ClaudioBorges/MicroFEI-SmartCarBrazil2011/Hardware/PCB/TFC - car - BRD.pdf

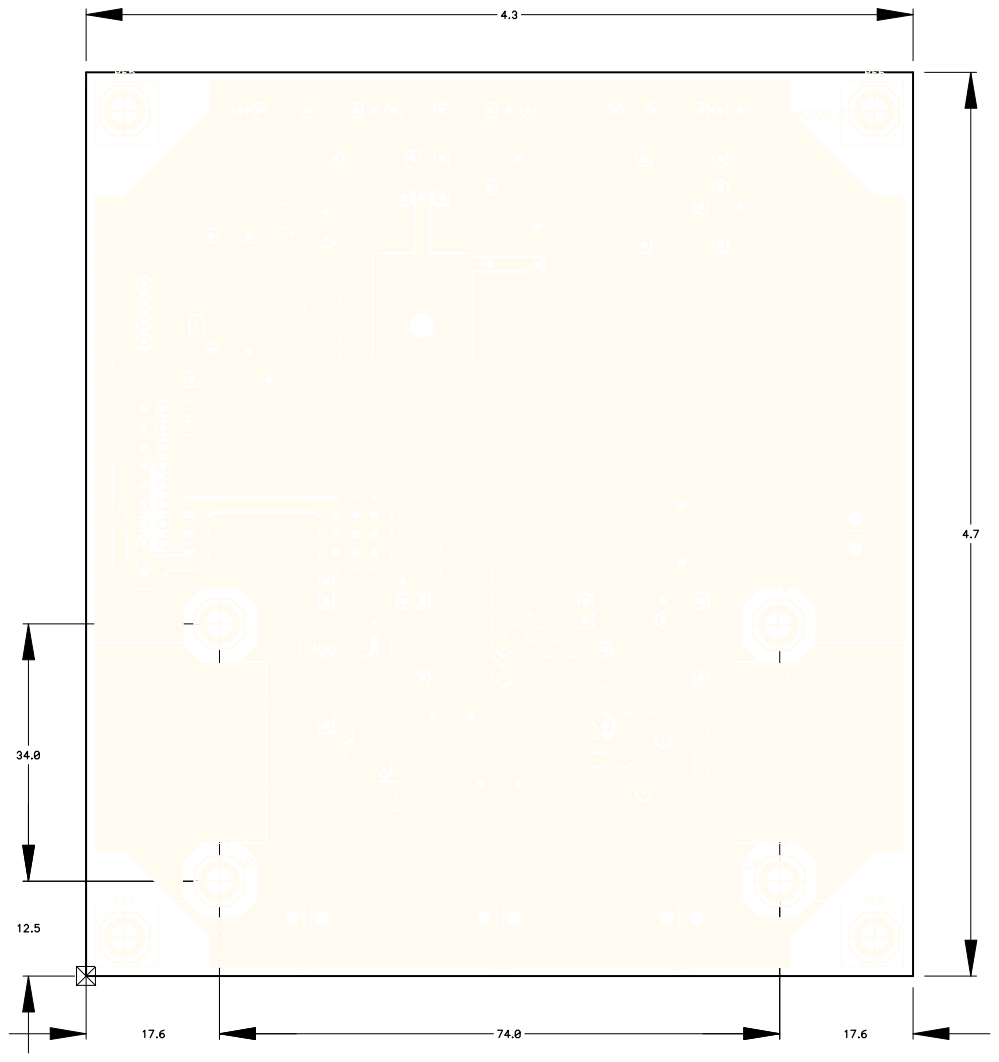
[picture p24: page 1]
