ClaudioBorges/MicroFEI-SmartCarBrazil2011/Hardware/PCB/TFC - car - SCH.pdf

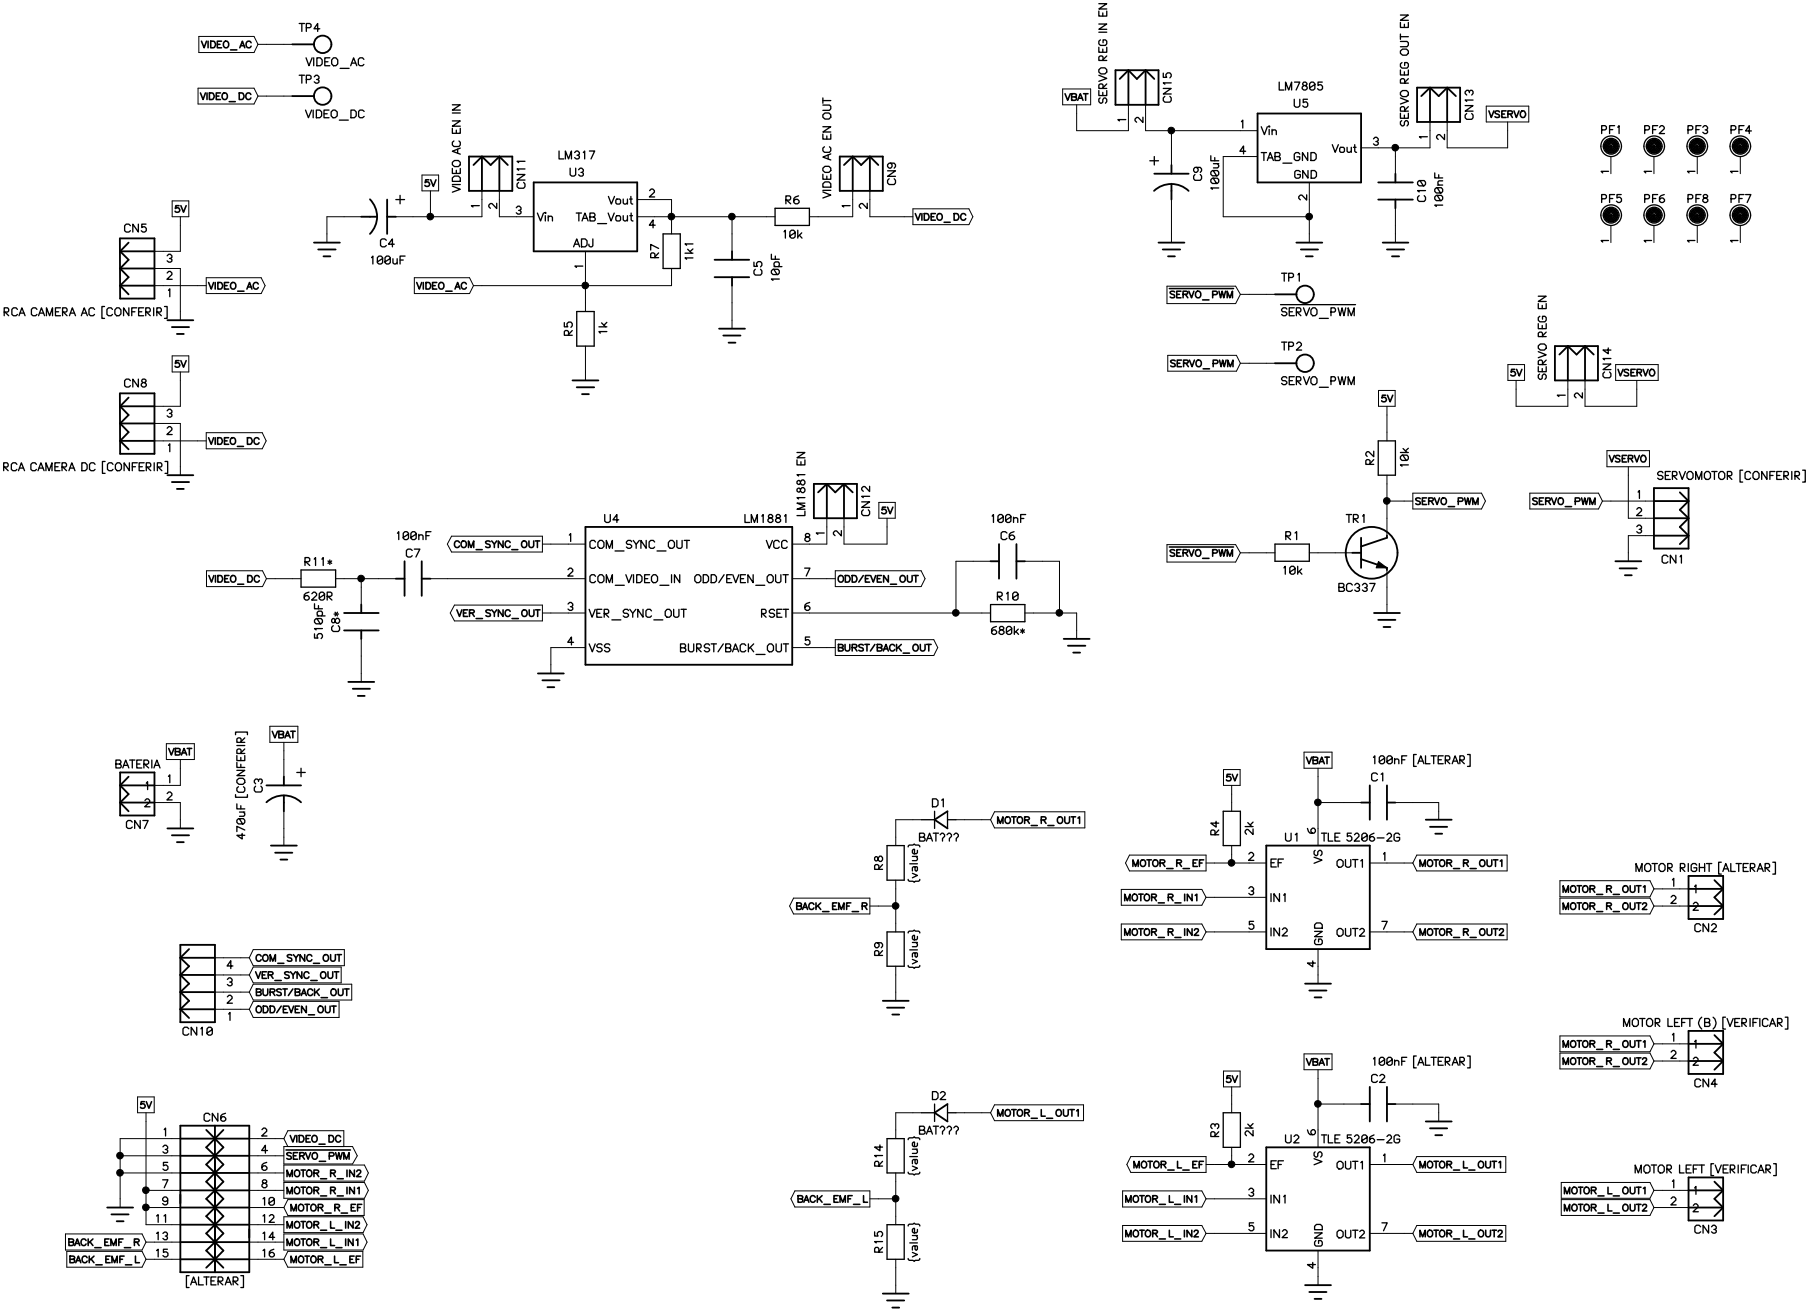
[picture p25: page 1]
