ClaudioBorges/MicroFEI-SmartCarBrazil2011/Hardware/PCB/TFC - car - SLK.pdf

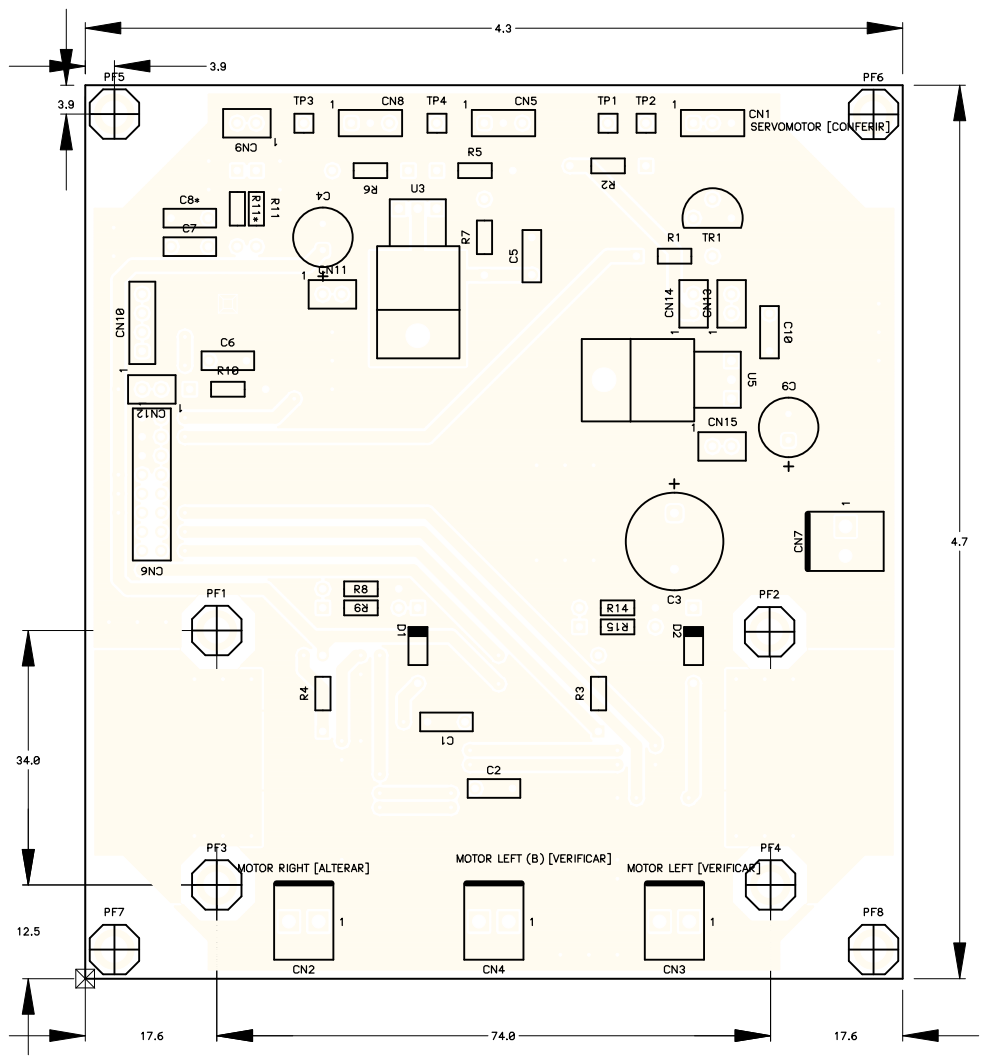
[picture p26: page 1]
