ClaudioBorges/MicroFEI-SmartCarBrazil2011/(list of files, drawings)

Other design files:
Hardware/PCB/TFC - car.pcb
