ClaudioBorges/MicroFEI-SmartCarBrazil2011/TFC - SmartCar/SIU/siu_init.c

/*
 *######################################################################
 *                                RAppIDJDP
 *           Rapid Application Initialization and Documentation Tool
 *                         Freescale Semiconductor Inc.
 *
 *######################################################################
 *
 * Project Name           : SAIC ADC
 *
 * Project File           : SAIC ADC.rsp
 *
 * Revision Number        : 1.0
 *
 * Tool Version           : 1.3.1.6
 *
 * file                   : siu_init.c
 *
 * Target Compiler        : Diab
 *
 * Target Part            : MPC5604B
 *
 * Part Errata Fixes      : none
 *
 * Project Last Save Date : 06-Aug-2011 14:36:06
 *
 * Created on Date        : 06-Aug-2011 14:36:10
 *
 * Brief Description      : This File Contains Pads, external Interrupts and
 *                          Wakeups configuration
 *
 ******************************************************************************** 
 *
 * Detail Description     : This File contains function for peripheral assignment
 *                         for each pads, External Interrupt configuration,
 *                         Wakeup configuration and Trigger configuration.
 *                         It also handles Port parallel masking.
 *
 ******************************************************************************** 
 *
 *######################################################################
*/

 
 
/********************  Dependent Include files here **********************/

#include "siu_init.h"
#include "MPC5604B_0M27V_0102.h" /* Use proper include file */

/* ----------------------------------------------------------- */
/*	                SIU Initialization                         */
/* ----------------------------------------------------------- */
void siu_init_fnc(void)
{
    siu_portA_init_fnc();
    siu_portB_init_fnc();
    siu_portC_init_fnc();
    siu_portD_init_fnc();
    siu_portE_init_fnc();
    siu_portF_init_fnc();
    siu_portG_init_fnc();
    siu_portH_init_fnc();
    siu_general_init_fnc();
    siu_parallel_port_init_fnc();
    siu_unused_pins_init_fnc();
    siu_psmi_init_fnc();
}


/* ----------------------------------------------------------- */
/*                 SIU PORT A PAD Configuration                 */
/* ----------------------------------------------------------- */
void siu_portA_init_fnc(void)
{
    /* ----------------------------------------------------------- */
    /*      Pad Configuration Register PCR[0]  eMIOS_0_0_CLKOUT_PA0 (16) */
    /* ----------------------------------------------------------- */
       SIU.PCR[0].R = 0x0501;
             /* User Assigned Signal Name : SAIC_CH0  */
             /*	Selected Function : eMIOS_0_0 I          */
             /*	Output Buffers : Disabled         */
             /*	Input Buffers : Enabled           */
             /*	Output Drain : Disabled           */
             /*	Slew Rate Control : Minimum       */
             /*	Weak Pull Up/Down : Disabled      */
             /*	Weak Pull Up/Down Select : Up     */
             /*	Safe Mode Control: Disabled       */

    /* ----------------------------------------------------------- */
    /*      Pad Configuration Register PCR[1]  eMIOS_0_1_NMI_PA1 (11) */
    /* ----------------------------------------------------------- */
       SIU.PCR[1].R = 0x0601;
             /*	Selected Function : eMIOS_0_1 O          */
             /*	Output Buffers : Enabled          */
             /*	Input Buffers : Disabled          */
             /*	Output Drain : Disabled           */
             /*	Slew Rate Control : Minimum       */
             /*	Weak Pull Up/Down : Disabled      */
             /*	Weak Pull Up/Down Select : Up     */
             /*	Safe Mode Control: Disabled       */

    /* ----------------------------------------------------------- */
    /*      Pad Configuration Register PCR[2]  eMIOS_0_2_PA2 (9) */
    /* ----------------------------------------------------------- */
       SIU.PCR[2].R = 0x0001;
             /*	Selected Function : PA2          */
             /*	Output Buffers : Disabled         */
             /*	Input Buffers : Disabled          */
             /*	Output Drain : Disabled           */
             /*	Slew Rate Control : Minimum       */
             /*	Weak Pull Up/Down : Disabled      */
             /*	Weak Pull Up/Down Select : Up     */
             /*	Safe Mode Control: Disabled       */

    /* ----------------------------------------------------------- */
    /*      Pad Configuration Register PCR[3]  eMIOS_0_3_PA3 (90) */
    /* ----------------------------------------------------------- */
       SIU.PCR[3].R = 0x0001;
             /*	Selected Function : PA3          */
             /*	Output Buffers : Disabled         */
             /*	Input Buffers : Disabled          */
             /*	Output Drain : Disabled           */
             /*	Slew Rate Control : Minimum       */
             /*	Weak Pull Up/Down : Disabled      */
             /*	Weak Pull Up/Down Select : Up     */
             /*	Safe Mode Control: Disabled       */

    /* ----------------------------------------------------------- */
    /*      Pad Configuration Register PCR[4]  eMIOS_0_4_PA4 (43) */
    /* ----------------------------------------------------------- */
       SIU.PCR[4].R = 0x0001;
             /*	Selected Function : PA4          */
             /*	Output Buffers : Disabled         */
             /*	Input Buffers : Disabled          */
             /*	Output Drain : Disabled           */
             /*	Slew Rate Control : Minimum       */
             /*	Weak Pull Up/Down : Disabled      */
             /*	Weak Pull Up/Down Select : Up     */
             /*	Safe Mode Control: Disabled       */

    /* ----------------------------------------------------------- */
    /*      Pad Configuration Register PCR[5]  eMIOS_0_5_PA5 (118) */
    /* ----------------------------------------------------------- */
       SIU.PCR[5].R = 0x0001;
             /*	Selected Function : PA5          */
             /*	Output Buffers : Disabled         */
             /*	Input Buffers : Disabled          */
             /*	Output Drain : Disabled           */
             /*	Slew Rate Control : Minimum       */
             /*	Weak Pull Up/Down : Disabled      */
             /*	Weak Pull Up/Down Select : Up     */
             /*	Safe Mode Control: Disabled       */

    /* ----------------------------------------------------------- */
    /*      Pad Configuration Register PCR[6]  eMIOS_0_6_PA6 (119) */
    /* ----------------------------------------------------------- */
       SIU.PCR[6].R = 0x0001;
             /*	Selected Function : PA6          */
             /*	Output Buffers : Disabled         */
             /*	Input Buffers : Disabled          */
             /*	Output Drain : Disabled           */
             /*	Slew Rate Control : Minimum       */
             /*	Weak Pull Up/Down : Disabled      */
             /*	Weak Pull Up/Down Select : Up     */
             /*	Safe Mode Control: Disabled       */

    /* ----------------------------------------------------------- */
    /*      Pad Configuration Register PCR[7]  eMIOS_0_7_TXD_3_PA7 (104) */
    /* ----------------------------------------------------------- */
       SIU.PCR[7].R = 0x0001;
             /*	Selected Function : PA7          */
             /*	Output Buffers : Disabled         */
             /*	Input Buffers : Disabled          */
             /*	Output Drain : Disabled           */
             /*	Slew Rate Control : Minimum       */
             /*	Weak Pull Up/Down : Disabled      */
             /*	Weak Pull Up/Down Select : Up     */
             /*	Safe Mode Control: Disabled       */

    /* ----------------------------------------------------------- */
    /*      Pad Configuration Register PCR[8]  eMIOS_0_8_RXD_3_PA8 (105) */
    /* ----------------------------------------------------------- */
       SIU.PCR[8].R = 0x0103;
             /*	Selected Function : PA8 I          */
             /*	Output Buffers : Disabled         */
             /*	Input Buffers : Enabled           */
             /*	Output Drain : Disabled           */
             /*	Slew Rate Control : Minimum       */
             /*	Weak Pull Up/Down : Enabled       */
             /*	Weak Pull Up/Down Select : Up     */
             /*	Safe Mode Control: Disabled       */

    /* ----------------------------------------------------------- */
    /*      Pad Configuration Register PCR[9]  eMIOS_0_9_PA9 (106) */
    /* ----------------------------------------------------------- */
       SIU.PCR[9].R = 0x0102;
             /*	Selected Function : PA9 I          */
             /*	Output Buffers : Disabled         */
             /*	Input Buffers : Enabled           */
             /*	Output Drain : Disabled           */
             /*	Slew Rate Control : Minimum       */
             /*	Weak Pull Up/Down : Enabled       */
             /*	Weak Pull Up/Down Select : Down   */
             /*	Safe Mode Control: Disabled       */

    /* ----------------------------------------------------------- */
    /*      Pad Configuration Register PCR[10]  eMIOS_0_10_SDA_0_PA10 (107) */
    /* ----------------------------------------------------------- */
       SIU.PCR[10].R = 0x0001;
             /*	Selected Function : PA10          */
             /*	Output Buffers : Disabled         */
             /*	Input Buffers : Disabled          */
             /*	Output Drain : Disabled           */
             /*	Slew Rate Control : Minimum       */
             /*	Weak Pull Up/Down : Disabled      */
             /*	Weak Pull Up/Down Select : Up     */
             /*	Safe Mode Control: Disabled       */

    /* ----------------------------------------------------------- */
    /*      Pad Configuration Register PCR[11]  eMIOS_0_11_SCL_0_PA11 (108) */
    /* ----------------------------------------------------------- */
       SIU.PCR[11].R = 0x0001;
             /*	Selected Function : PA11          */
             /*	Output Buffers : Disabled         */
             /*	Input Buffers : Disabled          */
             /*	Output Drain : Disabled           */
             /*	Slew Rate Control : Minimum       */
             /*	Weak Pull Up/Down : Disabled      */
             /*	Weak Pull Up/Down Select : Up     */
             /*	Safe Mode Control: Disabled       */

    /* ----------------------------------------------------------- */
    /*      Pad Configuration Register PCR[12]  SIN_0_PA12 (45) */
    /* ----------------------------------------------------------- */
       SIU.PCR[12].R = 0x0001;
             /*	Selected Function : PA12          */
             /*	Output Buffers : Disabled         */
             /*	Input Buffers : Disabled          */
             /*	Output Drain : Disabled           */
             /*	Slew Rate Control : Minimum       */
             /*	Weak Pull Up/Down : Disabled      */
             /*	Weak Pull Up/Down Select : Up     */
             /*	Safe Mode Control: Disabled       */

    /* ----------------------------------------------------------- */
    /*      Pad Configuration Register PCR[13]  SOUT_0_PA13 (44) */
    /* ----------------------------------------------------------- */
       SIU.PCR[13].R = 0x0001;
             /*	Selected Function : PA13          */
             /*	Output Buffers : Disabled         */
             /*	Input Buffers : Disabled          */
             /*	Output Drain : Disabled           */
             /*	Slew Rate Control : Minimum       */
             /*	Weak Pull Up/Down : Disabled      */
             /*	Weak Pull Up/Down Select : Up     */
             /*	Safe Mode Control: Disabled       */

    /* ----------------------------------------------------------- */
    /*      Pad Configuration Register PCR[14]  SCK_0_PCS_0.0_PA14 (42) */
    /* ----------------------------------------------------------- */
       SIU.PCR[14].R = 0x0001;
             /*	Selected Function : PA14          */
             /*	Output Buffers : Disabled         */
             /*	Input Buffers : Disabled          */
             /*	Output Drain : Disabled           */
             /*	Slew Rate Control : Minimum       */
             /*	Weak Pull Up/Down : Disabled      */
             /*	Weak Pull Up/Down Select : Up     */
             /*	Safe Mode Control: Disabled       */

    /* ----------------------------------------------------------- */
    /*      Pad Configuration Register PCR[15]  PCS_0.0_SCK_0_PA15 (40) */
    /* ----------------------------------------------------------- */
       SIU.PCR[15].R = 0x0001;
             /*	Selected Function : PA15          */
             /*	Output Buffers : Disabled         */
             /*	Input Buffers : Disabled          */
             /*	Output Drain : Disabled           */
             /*	Slew Rate Control : Minimum       */
             /*	Weak Pull Up/Down : Disabled      */
             /*	Weak Pull Up/Down Select : Up     */
             /*	Safe Mode Control: Disabled       */

}


/* ----------------------------------------------------------- */
/*                 SIU PORT B PAD Configuration                 */
/* ----------------------------------------------------------- */
void siu_portB_init_fnc(void)
{
    /* ----------------------------------------------------------- */
    /*      Pad Configuration Register PCR[16]  CNTX_0_PB0 (31) */
    /* ----------------------------------------------------------- */
       SIU.PCR[16].R = 0x0001;
             /*	Selected Function : PB0          */
             /*	Output Buffers : Disabled         */
             /*	Input Buffers : Disabled          */
             /*	Output Drain : Disabled           */
             /*	Slew Rate Control : Minimum       */
             /*	Weak Pull Up/Down : Disabled      */
             /*	Weak Pull Up/Down Select : Up     */
             /*	Safe Mode Control: Disabled       */

    /* ----------------------------------------------------------- */
    /*      Pad Configuration Register PCR[17]  CNRX_0_PB1 (32) */
    /* ----------------------------------------------------------- */
       SIU.PCR[17].R = 0x0001;
             /*	Selected Function : PB1          */
             /*	Output Buffers : Disabled         */
             /*	Input Buffers : Disabled          */
             /*	Output Drain : Disabled           */
             /*	Slew Rate Control : Minimum       */
             /*	Weak Pull Up/Down : Disabled      */
             /*	Weak Pull Up/Down Select : Up     */
             /*	Safe Mode Control: Disabled       */

    /* ----------------------------------------------------------- */
    /*      Pad Configuration Register PCR[18]  TXD_0_SDA_0_PB2 (144) */
    /* ----------------------------------------------------------- */
       SIU.PCR[18].R = 0x0001;
             /*	Selected Function : PB2          */
             /*	Output Buffers : Disabled         */
             /*	Input Buffers : Disabled          */
             /*	Output Drain : Disabled           */
             /*	Slew Rate Control : Minimum       */
             /*	Weak Pull Up/Down : Disabled      */
             /*	Weak Pull Up/Down Select : Up     */
             /*	Safe Mode Control: Disabled       */

    /* ----------------------------------------------------------- */
    /*      Pad Configuration Register PCR[19]  RXD_0_SCL_0_PB3 (1) */
    /* ----------------------------------------------------------- */
       SIU.PCR[19].R = 0x0001;
             /*	Selected Function : PB3          */
             /*	Output Buffers : Disabled         */
             /*	Input Buffers : Disabled          */
             /*	Output Drain : Disabled           */
             /*	Slew Rate Control : Minimum       */
             /*	Weak Pull Up/Down : Disabled      */
             /*	Weak Pull Up/Down Select : Up     */
             /*	Safe Mode Control: Disabled       */

    /* ----------------------------------------------------------- */
    /*      Pad Configuration Register PCR[20]  ADC0_ANP0_PB4 (72) */
    /* ----------------------------------------------------------- */
       SIU.PCR[20].R = 0x0000;
             /*	Selected Function : PB4          */
             /*	Output Buffers : Disabled         */
             /*	Input Buffers : Disabled          */
             /*	Output Drain : Disabled           */
             /*	Slew Rate Control : Minimum       */
             /*	Weak Pull Up/Down : Disabled      */
             /*	Weak Pull Up/Down Select : Down   */
             /*	Safe Mode Control: Disabled       */

    /* ----------------------------------------------------------- */
    /*      Pad Configuration Register PCR[21]  ADC0_ANP1_PB5 (75) */
    /* ----------------------------------------------------------- */
       SIU.PCR[21].R = 0x0000;
             /*	Selected Function : PB5          */
             /*	Output Buffers : Disabled         */
             /*	Input Buffers : Disabled          */
             /*	Output Drain : Disabled           */
             /*	Slew Rate Control : Minimum       */
             /*	Weak Pull Up/Down : Disabled      */
             /*	Weak Pull Up/Down Select : Down   */
             /*	Safe Mode Control: Disabled       */

    /* ----------------------------------------------------------- */
    /*      Pad Configuration Register PCR[22]  ADC0_ANP2_PB6 (76) */
    /* ----------------------------------------------------------- */
       SIU.PCR[22].R = 0x0000;
             /*	Selected Function : PB6          */
             /*	Output Buffers : Disabled         */
             /*	Input Buffers : Disabled          */
             /*	Output Drain : Disabled           */
             /*	Slew Rate Control : Minimum       */
             /*	Weak Pull Up/Down : Disabled      */
             /*	Weak Pull Up/Down Select : Down   */
             /*	Safe Mode Control: Disabled       */

    /* ----------------------------------------------------------- */
    /*      Pad Configuration Register PCR[23]  ADC0_ANP3_PB7 (77) */
    /* ----------------------------------------------------------- */
       SIU.PCR[23].R = 0x0000;
             /*	Selected Function : PB7          */
             /*	Output Buffers : Disabled         */
             /*	Input Buffers : Disabled          */
             /*	Output Drain : Disabled           */
             /*	Slew Rate Control : Minimum       */
             /*	Weak Pull Up/Down : Disabled      */
             /*	Weak Pull Up/Down Select : Down   */
             /*	Safe Mode Control: Disabled       */

    /* ----------------------------------------------------------- */
    /*      Pad Configuration Register PCR[24]  XTAL32_ADC0_ANS0_PB8 (53) */
    /* ----------------------------------------------------------- */
       SIU.PCR[24].R = 0x2000;
             /* User Assigned Signal Name : ADC_ANS_0  */
             /*	Selected Function : ADC0_ANS0          */
             /*	Output Buffers : Disabled         */
             /*	Input Buffers : Disabled          */
             /*	Output Drain : Disabled           */
             /*	Slew Rate Control : Minimum       */
             /*	Weak Pull Up/Down : Disabled      */
             /*	Weak Pull Up/Down Select : Down   */
             /*	Safe Mode Control: Disabled       */

    /* ----------------------------------------------------------- */
    /*      Pad Configuration Register PCR[25]  EXTAL32_ADC0_ANS1_PB9 (52) */
    /* ----------------------------------------------------------- */
       SIU.PCR[25].R = 0x0000;
             /*	Selected Function : PB9          */
             /*	Output Buffers : Disabled         */
             /*	Input Buffers : Disabled          */
             /*	Output Drain : Disabled           */
             /*	Slew Rate Control : Minimum       */
             /*	Weak Pull Up/Down : Disabled      */
             /*	Weak Pull Up/Down Select : Down   */
             /*	Safe Mode Control: Disabled       */

    /* ----------------------------------------------------------- */
    /*      Pad Configuration Register PCR[26]  ADC0_ANS2_PB10 (54) */
    /* ----------------------------------------------------------- */
       SIU.PCR[26].R = 0x0001;
             /*	Selected Function : PB10          */
             /*	Output Buffers : Disabled         */
             /*	Input Buffers : Disabled          */
             /*	Output Drain : Disabled           */
             /*	Slew Rate Control : Minimum       */
             /*	Weak Pull Up/Down : Disabled      */
             /*	Weak Pull Up/Down Select : Up     */
             /*	Safe Mode Control: Disabled       */

    /* ----------------------------------------------------------- */
    /*      Pad Configuration Register PCR[27]  eMIOS_0_3_PCS_0.0_ADC0_ANS3_PB11 (81) */
    /* ----------------------------------------------------------- */
       SIU.PCR[27].R = 0x0001;
             /*	Selected Function : PB11          */
             /*	Output Buffers : Disabled         */
             /*	Input Buffers : Disabled          */
             /*	Output Drain : Disabled           */
             /*	Slew Rate Control : Minimum       */
             /*	Weak Pull Up/Down : Disabled      */
             /*	Weak Pull Up/Down Select : Up     */
             /*	Safe Mode Control: Disabled       */

    /* ----------------------------------------------------------- */
    /*      Pad Configuration Register PCR[28]  eMIOS_0_4_PCS_0.1_ADC0_ANX0_PB12 (83) */
    /* ----------------------------------------------------------- */
       SIU.PCR[28].R = 0x0001;
             /*	Selected Function : PB12          */
             /*	Output Buffers : Disabled         */
             /*	Input Buffers : Disabled          */
             /*	Output Drain : Disabled           */
             /*	Slew Rate Control : Minimum       */
             /*	Weak Pull Up/Down : Disabled      */
             /*	Weak Pull Up/Down Select : Up     */
             /*	Safe Mode Control: Disabled       */

    /* ----------------------------------------------------------- */
    /*      Pad Configuration Register PCR[29]  eMIOS_0_5_PCS_0.2_ADC0_ANX1_PB13 (85) */
    /* ----------------------------------------------------------- */
       SIU.PCR[29].R = 0x0001;
             /*	Selected Function : PB13          */
             /*	Output Buffers : Disabled         */
             /*	Input Buffers : Disabled          */
             /*	Output Drain : Disabled           */
             /*	Slew Rate Control : Minimum       */
             /*	Weak Pull Up/Down : Disabled      */
             /*	Weak Pull Up/Down Select : Up     */
             /*	Safe Mode Control: Disabled       */

    /* ----------------------------------------------------------- */
    /*      Pad Configuration Register PCR[30]  eMIOS_0_6_PCS_0.3_ADC0_ANX2_PB14 (87) */
    /* ----------------------------------------------------------- */
       SIU.PCR[30].R = 0x0001;
             /*	Selected Function : PB14          */
             /*	Output Buffers : Disabled         */
             /*	Input Buffers : Disabled          */
             /*	Output Drain : Disabled           */
             /*	Slew Rate Control : Minimum       */
             /*	Weak Pull Up/Down : Disabled      */
             /*	Weak Pull Up/Down Select : Up     */
             /*	Safe Mode Control: Disabled       */

    /* ----------------------------------------------------------- */
    /*      Pad Configuration Register PCR[31]  eMIOS_0_7_PCS_0.4_ADC0_ANX3_PB15 (89) */
    /* ----------------------------------------------------------- */
       SIU.PCR[31].R = 0x0001;
             /*	Selected Function : PB15          */
             /*	Output Buffers : Disabled         */
             /*	Input Buffers : Disabled          */
             /*	Output Drain : Disabled           */
             /*	Slew Rate Control : Minimum       */
             /*	Weak Pull Up/Down : Disabled      */
             /*	Weak Pull Up/Down Select : Up     */
             /*	Safe Mode Control: Disabled       */

}


/* ----------------------------------------------------------- */
/*                 SIU PORT C PAD Configuration                 */
/* ----------------------------------------------------------- */
void siu_portC_init_fnc(void)
{
    /* ----------------------------------------------------------- */
    /*      Pad Configuration Register PCR[32]  TDI_PC0 (126) */
    /* ----------------------------------------------------------- */
       SIU.PCR[32].R = 0x4903;
             /*	Selected Function : TDI          */
             /*	Output Buffers : Disabled         */
             /*	Input Buffers : Enabled           */
             /*	Output Drain : Disabled           */
             /*	Slew Rate Control : Minimum       */
             /*	Weak Pull Up/Down : Enabled       */
             /*	Weak Pull Up/Down Select : Up     */
             /*	Safe Mode Control: Enabled       */

    /* ----------------------------------------------------------- */
    /*      Pad Configuration Register PCR[33]  TDO_PC1 (121) */
    /* ----------------------------------------------------------- */
       SIU.PCR[33].R = 0x4A01;
             /*	Selected Function : TDO          */
             /*	Output Buffers : Enabled          */
             /*	Input Buffers : Disabled          */
             /*	Output Drain : Disabled           */
             /*	Slew Rate Control : Minimum       */
             /*	Weak Pull Up/Down : Disabled      */
             /*	Weak Pull Up/Down Select : Up     */
             /*	Safe Mode Control: Enabled       */

    /* ----------------------------------------------------------- */
    /*      Pad Configuration Register PCR[34]  SCK_1_PC2 (117) */
    /* ----------------------------------------------------------- */
       SIU.PCR[34].R = 0x0001;
             /*	Selected Function : PC2          */
             /*	Output Buffers : Disabled         */
             /*	Input Buffers : Disabled          */
             /*	Output Drain : Disabled           */
             /*	Slew Rate Control : Minimum       */
             /*	Weak Pull Up/Down : Disabled      */
             /*	Weak Pull Up/Down Select : Up     */
             /*	Safe Mode Control: Disabled       */

    /* ----------------------------------------------------------- */
    /*      Pad Configuration Register PCR[35]  PCS_1.0_ADC_MA0_CNRX_1_PC3 (116) */
    /* ----------------------------------------------------------- */
       SIU.PCR[35].R = 0x0001;
             /*	Selected Function : PC3          */
             /*	Output Buffers : Disabled         */
             /*	Input Buffers : Disabled          */
             /*	Output Drain : Disabled           */
             /*	Slew Rate Control : Minimum       */
             /*	Weak Pull Up/Down : Disabled      */
             /*	Weak Pull Up/Down Select : Up     */
             /*	Safe Mode Control: Disabled       */

    /* ----------------------------------------------------------- */
    /*      Pad Configuration Register PCR[36]  SIN_1_PC4 (131) */
    /* ----------------------------------------------------------- */
       SIU.PCR[36].R = 0x0001;
             /*	Selected Function : PC4          */
             /*	Output Buffers : Disabled         */
             /*	Input Buffers : Disabled          */
             /*	Output Drain : Disabled           */
             /*	Slew Rate Control : Minimum       */
             /*	Weak Pull Up/Down : Disabled      */
             /*	Weak Pull Up/Down Select : Up     */
             /*	Safe Mode Control: Disabled       */

    /* ----------------------------------------------------------- */
    /*      Pad Configuration Register PCR[37]  SOUT_1_PC5 (130) */
    /* ----------------------------------------------------------- */
       SIU.PCR[37].R = 0x0001;
             /*	Selected Function : PC5          */
             /*	Output Buffers : Disabled         */
             /*	Input Buffers : Disabled          */
             /*	Output Drain : Disabled           */
             /*	Slew Rate Control : Minimum       */
             /*	Weak Pull Up/Down : Disabled      */
             /*	Weak Pull Up/Down Select : Up     */
             /*	Safe Mode Control: Disabled       */

    /* ----------------------------------------------------------- */
    /*      Pad Configuration Register PCR[38]  TXD_1_PC6 (36) */
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
             /*	Output Drain : Disabled           */
             /*	Slew Rate Control : Minimum       */
             /*	Weak Pull Up/Down : Disabled      */
             /*	Weak Pull Up/Down Select : Up     */
             /*	Safe Mode Control: Disabled       */

    /* ----------------------------------------------------------- */
    /*      Pad Configuration Register PCR[44]  eMIOS_0_12_SIN_2_PC12 (141) */
    /* ----------------------------------------------------------- */
       SIU.PCR[44].R = 0x0001;
             /*	Selected Function : PC12          */
             /*	Output Buffers : Disabled         */
             /*	Input Buffers : Disabled          */
             /*	Output Drain : Disabled           */
             /*	Slew Rate Control : Minimum       */
             /*	Weak Pull Up/Down : Disabled      */
             /*	Weak Pull Up/Down Select : Up     */
             /*	Safe Mode Control: Disabled       */

    /* ----------------------------------------------------------- */
    /*      Pad Configuration Register PCR[45]  eMIOS_0_13_SOUT_2_PC13 (142) */
    /* ----------------------------------------------------------- */
       SIU.PCR[45].R = 0x0001;
             /*	Selected Function : PC13          */
             /*	Output Buffers : Disabled         */
             /*	Input Buffers : Disabled          */
             /*	Output Drain : Disabled           */
             /*	Slew Rate Control : Minimum       */
             /*	Weak Pull Up/Down : Disabled      */
             /*	Weak Pull Up/Down Select : Up     */
             /*	Safe Mode Control: Disabled       */

    /* ----------------------------------------------------------- */
    /*      Pad Configuration Register PCR[46]  eMIOS_0_14_SCK_2_PC14 (3) */
    /* ----------------------------------------------------------- */
       SIU.PCR[46].R = 0x0001;
             /*	Selected Function : PC14          */
             /*	Output Buffers : Disabled         */
             /*	Input Buffers : Disabled          */
             /*	Output Drain : Disabled           */
             /*	Slew Rate Control : Minimum       */
             /*	Weak Pull Up/Down : Disabled      */
             /*	Weak Pull Up/Down Select : Up     */
             /*	Safe Mode Control: Disabled       */

    /* ----------------------------------------------------------- */
    /*      Pad Configuration Register PCR[47]  eMIOS_0_15_PCS_2.0_PC15 (4) */
    /* ----------------------------------------------------------- */
       SIU.PCR[47].R = 0x0001;
             /*	Selected Function : PC15          */
             /*	Output Buffers : Disabled         */
             /*	Input Buffers : Disabled          */
             /*	Output Drain : Disabled           */
             /*	Slew Rate Control : Minimum       */
             /*	Weak Pull Up/Down : Disabled      */
             /*	Weak Pull Up/Down Select : Up     */
             /*	Safe Mode Control: Disabled       */

}


/* ----------------------------------------------------------- */
/*                 SIU PORT D PAD Configuration                 */
/* ----------------------------------------------------------- */
void siu_portD_init_fnc(void)
{
    /* ----------------------------------------------------------- */
    /*      Pad Configuration Register PCR[48]  ADC0_ANP4_PD0 (63) */
    /* ----------------------------------------------------------- */
       SIU.PCR[48].R = 0x0000;
             /*	Selected Function : PD0          */
             /*	Output Buffers : Disabled         */
             /*	Input Buffers : Disabled          */
             /*	Output Drain : Disabled           */
             /*	Slew Rate Control : Minimum       */
             /*	Weak Pull Up/Down : Disabled      */
             /*	Weak Pull Up/Down Select : Down   */
             /*	Safe Mode Control: Disabled       */

    /* ----------------------------------------------------------- */
    /*      Pad Configuration Register PCR[49]  ADC0_ANP5_PD1 (64) */
    /* ----------------------------------------------------------- */
       SIU.PCR[49].R = 0x0000;
             /*	Selected Function : PD1          */
             /*	Output Buffers : Disabled         */
             /*	Input Buffers : Disabled          */
             /*	Output Drain : Disabled           */
             /*	Slew Rate Control : Minimum       */
             /*	Weak Pull Up/Down : Disabled      */
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
             /*	Output Drain : Disabled           */
             /*	Slew Rate Control : Minimum       */
             /*	Weak Pull Up/Down : Disabled      */
             /*	Weak Pull Up/Down Select : Up     */
             /*	Safe Mode Control: Disabled       */

}


/* ----------------------------------------------------------- */
/*                 SIU PORT E PAD Configuration                 */
/* ----------------------------------------------------------- */
void siu_portE_init_fnc(void)
{
    /* ----------------------------------------------------------- */
    /*      Pad Configuration Register PCR[64]  eMIOS_0_16_PE0 (10) */
    /* ----------------------------------------------------------- */
       SIU.PCR[64].R = 0x0001;
             /*	Selected Function : PE0          */
             /*	Output Buffers : Disabled         */
             /*	Input Buffers : Disabled          */
             /*	Output Drain : Disabled           */
             /*	Slew Rate Control : Minimum       */
             /*	Weak Pull Up/Down : Disabled      */
             /*	Weak Pull Up/Down Select : Up     */
             /*	Safe Mode Control: Disabled       */

    /* ----------------------------------------------------------- */
    /*      Pad Configuration Register PCR[65]  eMIOS_0_17_PE1 (12) */
    /* ----------------------------------------------------------- */
       SIU.PCR[65].R = 0x0001;
             /*	Selected Function : PE1          */
             /*	Output Buffers : Disabled         */
             /*	Input Buffers : Disabled          */
             /*	Output Drain : Disabled           */
             /*	Slew Rate Control : Minimum       */
             /*	Weak Pull Up/Down : Disabled      */
             /*	Weak Pull Up/Down Select : Up     */
             /*	Safe Mode Control: Disabled       */

    /* ----------------------------------------------------------- */
    /*      Pad Configuration Register PCR[66]  eMIOS_0_18_SIN_1_PE2 (128) */
    /* ----------------------------------------------------------- */
       SIU.PCR[66].R = 0x0001;
             /*	Selected Function : PE2          */
             /*	Output Buffers : Disabled         */
             /*	Input Buffers : Disabled          */
             /*	Output Drain : Disabled           */
             /*	Slew Rate Control : Minimum       */
             /*	Weak Pull Up/Down : Disabled      */
             /*	Weak Pull Up/Down Select : Up     */
             /*	Safe Mode Control: Disabled       */

    /* ----------------------------------------------------------- */
    /*      Pad Configuration Register PCR[67]  eMIOS_0_19_SOUT_1_PE3 (129) */
    /* ----------------------------------------------------------- */
       SIU.PCR[67].R = 0x0001;
             /*	Selected Function : PE3          */
             /*	Output Buffers : Disabled         */
             /*	Input Buffers : Disabled          */
             /*	Output Drain : Disabled           */
             /*	Slew Rate Control : Minimum       */
             /*	Weak Pull Up/Down : Disabled      */
             /*	Weak Pull Up/Down Select : Up     */
             /*	Safe Mode Control: Disabled       */

    /* ----------------------------------------------------------- */
    /*      Pad Configuration Register PCR[68]  eMIOS_0_20_SCK_1_PE4 (132) */
    /* ----------------------------------------------------------- */
       SIU.PCR[68].R = 0x0001;
             /*	Selected Function : PE4          */
             /*	Output Buffers : Disabled         */
             /*	Input Buffers : Disabled          */
             /*	Output Drain : Disabled           */
             /*	Slew Rate Control : Minimum       */
             /*	Weak Pull Up/Down : Disabled      */
             /*	Weak Pull Up/Down Select : Up     */
             /*	Safe Mode Control: Disabled       */

    /* ----------------------------------------------------------- */
    /*      Pad Configuration Register PCR[69]  eMIOS_0_21_PCS_1.0_ADC_MA2_PE5 (133) */
    /* ----------------------------------------------------------- */
       SIU.PCR[69].R = 0x0001;
             /*	Selected Function : PE5          */
             /*	Output Buffers : Disabled         */
             /*	Input Buffers : Disabled          */
             /*	Output Drain : Disabled           */
             /*	Slew Rate Control : Minimum       */
             /*	Weak Pull Up/Down : Disabled      */
             /*	Weak Pull Up/Down Select : Up     */
             /*	Safe Mode Control: Disabled       */

    /* ----------------------------------------------------------- */
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
             /*	Output Drain : Disabled           */
             /*	Slew Rate Control : Minimum       */
             /*	Weak Pull Up/Down : Disabled      */
             /*	Weak Pull Up/Down Select : Up     */
             /*	Safe Mode Control: Disabled       */

    /* ----------------------------------------------------------- */
    /*      Pad Configuration Register PCR[76]  SIN_2_eMIOS_1_19_PE12 (109) */
    /* ----------------------------------------------------------- */
       SIU.PCR[76].R = 0x0001;
             /*	Selected Function : PE12          */
             /*	Output Buffers : Disabled         */
             /*	Input Buffers : Disabled          */
             /*	Output Drain : Disabled           */
             /*	Slew Rate Control : Minimum       */
             /*	Weak Pull Up/Down : Disabled      */
             /*	Weak Pull Up/Down Select : Up     */
             /*	Safe Mode Control: Disabled       */

    /* ----------------------------------------------------------- */
    /*      Pad Configuration Register PCR[77]  SOUT_2_eMIOS_1_20_PE13 (103) */
    /* ----------------------------------------------------------- */
       SIU.PCR[77].R = 0x0001;
             /*	Selected Function : PE13          */
             /*	Output Buffers : Disabled         */
             /*	Input Buffers : Disabled          */
             /*	Output Drain : Disabled           */
             /*	Slew Rate Control : Minimum       */
             /*	Weak Pull Up/Down : Disabled      */
             /*	Weak Pull Up/Down Select : Up     */
             /*	Safe Mode Control: Disabled       */

    /* ----------------------------------------------------------- */
    /*      Pad Configuration Register PCR[78]  SCK_2_eMIOS_1_21_PE14 (112) */
    /* ----------------------------------------------------------- */
       SIU.PCR[78].R = 0x0001;
             /*	Selected Function : PE14          */
             /*	Output Buffers : Disabled         */
             /*	Input Buffers : Disabled          */
             /*	Output Drain : Disabled           */
             /*	Slew Rate Control : Minimum       */
             /*	Weak Pull Up/Down : Disabled      */
             /*	Weak Pull Up/Down Select : Up     */
             /*	Safe Mode Control: Disabled       */

    /* ----------------------------------------------------------- */
    /*      Pad Configuration Register PCR[79]  PCS_2.0_eMIOS_1_22_PE15 (113) */
    /* ----------------------------------------------------------- */
       SIU.PCR[79].R = 0x0001;
             /*	Selected Function : PE15          */
             /*	Output Buffers : Disabled         */
             /*	Input Buffers : Disabled          */
             /*	Output Drain : Disabled           */
             /*	Slew Rate Control : Minimum       */
             /*	Weak Pull Up/Down : Disabled      */
             /*	Weak Pull Up/Down Select : Up     */
             /*	Safe Mode Control: Disabled       */

}


/* ----------------------------------------------------------- */
/*                 SIU PORT F PAD Configuration                 */
/* ----------------------------------------------------------- */
void siu_portF_init_fnc(void)
{
    /* ----------------------------------------------------------- */
    /*      Pad Configuration Register PCR[80]  eMIOS_0_10_PCS_1.3_ADC0_ANS8_PF0 (55) */
    /* ----------------------------------------------------------- */
       SIU.PCR[80].R = 0x0001;
             /*	Selected Function : PF0          */
             /*	Output Buffers : Disabled         */
             /*	Input Buffers : Disabled          */
             /*	Output Drain : Disabled           */
             /*	Slew Rate Control : Minimum       */
             /*	Weak Pull Up/Down : Disabled      */
             /*	Weak Pull Up/Down Select : Up     */
             /*	Safe Mode Control: Disabled       */

    /* ----------------------------------------------------------- */
    /*      Pad Configuration Register PCR[81]  eMIOS_0_11_PCS_1.4_ADC0_ANS9_PF1 (56) */
    /* ----------------------------------------------------------- */
       SIU.PCR[81].R = 0x0001;
             /*	Selected Function : PF1          */
             /*	Output Buffers : Disabled         */
             /*	Input Buffers : Disabled          */
             /*	Output Drain : Disabled           */
             /*	Slew Rate Control : Minimum       */
             /*	Weak Pull Up/Down : Disabled      */
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
             /*	Output Drain : Disabled           */
             /*	Slew Rate Control : Minimum       */
             /*	Weak Pull Up/Down : Disabled      */
             /*	Weak Pull Up/Down Select : Up     */
             /*	Safe Mode Control: Disabled       */

}


/* ----------------------------------------------------------- */
/*                 SIU PORT H PAD Configuration                 */
/* ----------------------------------------------------------- */
void siu_portH_init_fnc(void)
{
    /* ----------------------------------------------------------- */
    /*      Pad Configuration Register PCR[112]  eMIOS_1_2_SIN_1_PH0 (93) */
    /* ----------------------------------------------------------- */
       SIU.PCR[112].R = 0x0001;
             /*	Selected Function : PH0          */
             /*	Output Buffers : Disabled         */
             /*	Input Buffers : Disabled          */
             /*	Output Drain : Disabled           */
             /*	Slew Rate Control : Minimum       */
             /*	Weak Pull Up/Down : Disabled      */
             /*	Weak Pull Up/Down Select : Up     */
             /*	Safe Mode Control: Disabled       */

    /* ----------------------------------------------------------- */
    /*      Pad Configuration Register PCR[113]  eMIOS_1_3_SOUT_1_PH1 (94) */
    /* ----------------------------------------------------------- */
       SIU.PCR[113].R = 0x0001;
             /*	Selected Function : PH1          */
             /*	Output Buffers : Disabled         */
             /*	Input Buffers : Disabled          */
             /*	Output Drain : Disabled           */
             /*	Slew Rate Control : Minimum       */
             /*	Weak Pull Up/Down : Disabled      */
             /*	Weak Pull Up/Down Select : Up     */
             /*	Safe Mode Control: Disabled       */

    /* ----------------------------------------------------------- */
    /*      Pad Configuration Register PCR[114]  eMIOS_1_4_SCK_1_PH2 (95) */
    /* ----------------------------------------------------------- */
       SIU.PCR[114].R = 0x0001;
             /*	Selected Function : PH2          */
             /*	Output Buffers : Disabled         */
             /*	Input Buffers : Disabled          */
             /*	Output Drain : Disabled           */
             /*	Slew Rate Control : Minimum       */
             /*	Weak Pull Up/Down : Disabled      */
             /*	Weak Pull Up/Down Select : Up     */
             /*	Safe Mode Control: Disabled       */

    /* ----------------------------------------------------------- */
    /*      Pad Configuration Register PCR[115]  eMIOS_1_5_PCS_1.0_PH3 (96) */
    /* ----------------------------------------------------------- */
       SIU.PCR[115].R = 0x0001;
             /*	Selected Function : PH3          */
             /*	Output Buffers : Disabled         */
             /*	Input Buffers : Disabled          */
             /*	Output Drain : Disabled           */
             /*	Slew Rate Control : Minimum       */
             /*	Weak Pull Up/Down : Disabled      */
             /*	Weak Pull Up/Down Select : Up     */
             /*	Safe Mode Control: Disabled       */

    /* ----------------------------------------------------------- */
    /*      Pad Configuration Register PCR[116]  eMIOS_1_6_PH4 (134) */
    /* ----------------------------------------------------------- */
       SIU.PCR[116].R = 0x0001;
             /*	Selected Function : PH4          */
             /*	Output Buffers : Disabled         */
             /*	Input Buffers : Disabled          */
             /*	Output Drain : Disabled           */
             /*	Slew Rate Control : Minimum       */
             /*	Weak Pull Up/Down : Disabled      */
             /*	Weak Pull Up/Down Select : Up     */
             /*	Safe Mode Control: Disabled       */

    /* ----------------------------------------------------------- */
    /*      Pad Configuration Register PCR[117]  eMIOS_1_7_PH5 (135) */
    /* ----------------------------------------------------------- */
       SIU.PCR[117].R = 0x0001;
             /*	Selected Function : PH5          */
             /*	Output Buffers : Disabled         */
             /*	Input Buffers : Disabled          */
             /*	Output Drain : Disabled           */
             /*	Slew Rate Control : Minimum       */
             /*	Weak Pull Up/Down : Disabled      */
             /*	Weak Pull Up/Down Select : Up     */
             /*	Safe Mode Control: Disabled       */

    /* ----------------------------------------------------------- */
    /*      Pad Configuration Register PCR[118]  eMIOS_1_8_ADC_MA2_PH6 (136) */
    /* ----------------------------------------------------------- */
       SIU.PCR[118].R = 0x0001;
             /*	Selected Function : PH6          */
             /*	Output Buffers : Disabled         */
             /*	Input Buffers : Disabled          */
             /*	Output Drain : Disabled           */
             /*	Slew Rate Control : Minimum       */
             /*	Weak Pull Up/Down : Disabled      */
             /*	Weak Pull Up/Down Select : Up     */
             /*	Safe Mode Control: Disabled       */

    /* ----------------------------------------------------------- */
    /*      Pad Configuration Register PCR[119]  eMIOS_1_9_PCS_2.3_ADC_MA1_PH7 (137) */
    /* ----------------------------------------------------------- */
       SIU.PCR[119].R = 0x0001;
             /*	Selected Function : PH7          */
             /*	Output Buffers : Disabled         */
             /*	Input Buffers : Disabled          */
             /*	Output Drain : Disabled           */
             /*	Slew Rate Control : Minimum       */
             /*	Weak Pull Up/Down : Disabled      */
             /*	Weak Pull Up/Down Select : Up     */
             /*	Safe Mode Control: Disabled       */

    /* ----------------------------------------------------------- */
    /*      Pad Configuration Register PCR[120]  eMIOS_1_10_PCS_2.2_ADC_MA0_PH8 (138) */
    /* ----------------------------------------------------------- */
       SIU.PCR[120].R = 0x0001;
             /*	Selected Function : PH8          */
             /*	Output Buffers : Disabled         */
             /*	Input Buffers : Disabled          */
             /*	Output Drain : Disabled           */
             /*	Slew Rate Control : Minimum       */
             /*	Weak Pull Up/Down : Disabled      */
             /*	Weak Pull Up/Down Select : Up     */
             /*	Safe Mode Control: Disabled       */

    /* ----------------------------------------------------------- */
    /*      Pad Configuration Register PCR[121]  TCK_PH9 (127) */
    /* ----------------------------------------------------------- */
       SIU.PCR[121].R = 0x4903;
             /*	Selected Function : TCK          */
             /*	Output Buffers : Disabled         */
             /*	Input Buffers : Enabled           */
             /*	Output Drain : Disabled           */
             /*	Slew Rate Control : Minimum       */
             /*	Weak Pull Up/Down : Enabled       */
             /*	Weak Pull Up/Down Select : Up     */
             /*	Safe Mode Control: Enabled       */

    /* ----------------------------------------------------------- */
    /*      Pad Configuration Register PCR[122]  TMS_PH10 (120) */
    /* ----------------------------------------------------------- */
       SIU.PCR[122].R = 0x4903;
             /*	Selected Function : TMS          */
             /*	Output Buffers : Disabled         */
             /*	Input Buffers : Enabled           */
             /*	Output Drain : Disabled           */
             /*	Slew Rate Control : Minimum       */
             /*	Weak Pull Up/Down : Enabled       */
             /*	Weak Pull Up/Down Select : Up     */
             /*	Safe Mode Control: Enabled       */

}


/* ----------------------------------------------------------- */
/*               SIU General PAD Configuration                 */
/* ----------------------------------------------------------- */
void siu_general_init_fnc(void)
{

    /* ----------------------------------------------------------- */
    /*   Interrupt Filter Clock Prescaler Register- IFCPR    */
    /* ----------------------------------------------------------- */
        SIU.IFCPR.R = 0x00000000;
 		    /* Filter Clock Prescalar:- 1     */

    /* ----------------------------------------------------------- */
    /*   Interrupt Request Enable Register- IRER    */
    /* ----------------------------------------------------------- */
        SIU.IRER.R = 0x00000000;
             /* Edge Trigger External Interrupt 0 Enable :-Disabled */
             /* Edge Trigger External Interrupt 1 Enable :-Disabled */
             /* Edge Trigger External Interrupt 2 Enable :-Disabled */
             /* Edge Trigger External Interrupt 3 Enable :-Disabled */
             /* Edge Trigger External Interrupt 4 Enable :-Disabled */
             /* Edge Trigger External Interrupt 5 Enable :-Disabled */
             /* Edge Trigger External Interrupt 6 Enable :-Disabled */
             /* Edge Trigger External Interrupt 7 Enable :-Disabled */
             /* Edge Trigger External Interrupt 8 Enable :-Disabled */
             /* Edge Trigger External Interrupt 9 Enable :-Disabled */
             /* Edge Trigger External Interrupt 10 Enable :-Disabled */
             /* Edge Trigger External Interrupt 11 Enable :-Disabled */
             /* Edge Trigger External Interrupt 12 Enable :-Disabled */
             /* Edge Trigger External Interrupt 13 Enable :-Disabled */
             /* Edge Trigger External Interrupt 14 Enable :-Disabled */
             /* Edge Trigger External Interrupt 15 Enable :-Disabled */

    /* ----------------------------------------------------------- */
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
             /* Wakeup 15 Falling-Edge Event :Disabled */
             /* Wakeup 16 Falling-Edge Event :Disabled */
             /* Wakeup 17 Falling-Edge Event :Disabled */
             /* Wakeup 18 Falling-Edge Event :Disabled */
             /* Wakeup 19 Falling-Edge Event :Disabled */

    /* ----------------------------------------------------------- */
    /*    Wakeup/Interrupt Filter Enable Register - WIFER    */
    /* ----------------------------------------------------------- */
        WKUP.WIFER.R = 0x00000000;
             /* Analog glitch filter on External Input2 Pad:- Disabled */
             /* Analog glitch filter on External Input3 Pad:- Disabled */
             /* Analog glitch filter on External Input4 Pad:- Disabled */
             /* Analog glitch filter on External Input5 Pad:- Disabled */
             /* Analog glitch filter on External Input6 Pad:- Disabled */
             /* Analog glitch filter on External Input7 Pad:- Disabled */
             /* Analog glitch filter on External Input8 Pad:- Disabled */
             /* Analog glitch filter on External Input9 Pad:- Disabled */
             /* Analog glitch filter on External Input10 Pad:- Disabled */
             /* Analog glitch filter on External Input11 Pad:- Disabled */
             /* Analog glitch filter on External Input12 Pad:- Disabled */
             /* Analog glitch filter on External Input13 Pad:- Disabled */
             /* Analog glitch filter on External Input14 Pad:- Disabled */
             /* Analog glitch filter on External Input15 Pad:- Disabled */
             /* Analog glitch filter on External Input16 Pad:- Disabled */
             /* Analog glitch filter on External Input17 Pad:- Disabled */
             /* Analog glitch filter on External Input18 Pad:- Disabled */
             /* Analog glitch filter on External Input19 Pad:- Disabled */



    /* ----------------------------------------------------------- */
    /*    Wakeup/Interrupt Pull up Enable Register - WIPUER    */
    /* ----------------------------------------------------------- */
        WKUP.WIPUER.R = 0x00000000;
           /* Pullup an unconnected wakeup/interrupt 2
                               input to a value of ‘1’ :-Disabled */
           /* Pullup an unconnected wakeup/interrupt 3
                               input to a value of ‘1’ :-Disabled */
           /* Pullup an unconnected wakeup/interrupt 4
                               input to a value of ‘1’ :-Disabled */
           /* Pullup an unconnected wakeup/interrupt 5
                               input to a value of ‘1’ :-Disabled */
           /* Pullup an unconnected wakeup/interrupt 6
                               input to a value of ‘1’ :-Disabled */
           /* Pullup an unconnected wakeup/interrupt 7
                               input to a value of ‘1’ :-Disabled */
           /* Pullup an unconnected wakeup/interrupt 8
                               input to a value of ‘1’ :-Disabled */
           /* Pullup an unconnected wakeup/interrupt 9
                               input to a value of ‘1’ :-Disabled */
           /* Pullup an unconnected wakeup/interrupt 10
                               input to a value of ‘1’ :-Disabled */
           /* Pullup an unconnected wakeup/interrupt 11
                               input to a value of ‘1’ :-Disabled */
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

/*-----------------------------------------------------------*/
/* Pad Selection for Multiplex Input Register PSMI[29]      */
/*-----------------------------------------------------------*/
               SIU.PSMI[29].R = 0x00;
                /*Function Pad Selected I2C_SCL :- PCR11*/

/*-----------------------------------------------------------*/
/* Pad Selection for Multiplex Input Register PSMI[30]      */
/*-----------------------------------------------------------*/
               SIU.PSMI[30].R = 0x00;
                /*Function Pad Selected I2C_SDA :- PCR10*/

/*-----------------------------------------------------------*/
/* Pad Selection for Multiplex Input Register PSMI[31]      */
/*-----------------------------------------------------------*/
               SIU.PSMI[31].R = 0x00;
                /*Function Pad Selected LIN3_RX :- PCR8*/

}



 
/*
 *######################################################################
 *                           End of File
 *######################################################################
*/
