ClaudioBorges/MicroFEI-SmartCarBrazil2011/TFC - SmartCar/SmartCar/INTC-SWvector-VLE/Sources/IntcIsrVectors.c

/* IntcIsrVectors.c - table of ISRs for INTC in SW vector Mode */
/* Description:  Contains addresses for 310 ISR vectors */
/*			     Table address gets loaded to INTC_IACKR */
/*               Alignment: MPC551x: 2 KB after a 4KB boundary; MPC555x: 64 KB*/
/* April 22, 2004 S. Mihalik */ 
/* March 16, 2006 S. Mihalik - Modified for compile with Diab 5.3 */
/* Jun 29 2006 SM - Used pragma align instead of hard coding address */
/* Jul  5 2007 SM - alignment now done in link file; changes for MPC551x */
/* Aug 30 2007 SM - Added pragma for CodeWarrior */
/* Oct 22 2008 SM - Changed to use PIT1 ISR instead of eMIOS Ch 0 ISR */

#include "typedefs.h"

void interrupt_handler(void);

extern void Pit0ISR(void);
extern void Pit1ISR(void);
extern void Pit2ISR(void);
extern void Pit3ISR(void);
extern void Pit4ISR(void);
extern void Pit5ISR(void);

extern void int_icCompSync(void);
extern void int_icVertPulse(void);
extern void int_icBurstGate(void);

extern void LINFlex_TXI(void);

/* Use next two lines with Diab compile */
/*#pragma section CONST ".intc_sw_isr_vector_table" */		 /* Diab compiler pragma */
/*const uint32_t IntcIsrVectorTable[] = {   */ 

/* Use pragma next two lines with CodeWarrior compile */
#pragma section data_type ".intc_sw_isr_vector_table" ".intc_sw_isr_vector_table" data_mode=far_abs  
uint32_t IntcIsrVectorTable[] = {
    (uint32_t)&interrupt_handler,    /* Vector - 0    interrupt_handler*/
    (uint32_t)&interrupt_handler,    /* Vector - 1    interrupt_handler*/
    (uint32_t)&interrupt_handler,    /* Vector - 2    interrupt_handler*/
    (uint32_t)&interrupt_handler,    /* Vector - 3    interrupt_handler*/
    (uint32_t)&interrupt_handler,    /* Vector - 4    interrupt_handler*/
    (uint32_t)&interrupt_handler,    /* Vector - 5    interrupt_handler*/
    (uint32_t)&interrupt_handler,    /* Vector - 6    interrupt_handler*/
    (uint32_t)&interrupt_handler,    /* Vector - 7    interrupt_handler*/
    (uint32_t)&interrupt_handler,    /* Vector - 8    Reserved */
    (uint32_t)&interrupt_handler,    /* Vector - 9    interrupt_handler*/
    (uint32_t)&interrupt_handler,    /* Vector - 10    Reserved */
    (uint32_t)&interrupt_handler,    /* Vector - 11    Reserved */
    (uint32_t)&interrupt_handler,    /* Vector - 12    Reserved */
    (uint32_t)&interrupt_handler,    /* Vector - 13    Reserved */
    (uint32_t)&interrupt_handler,    /* Vector - 14    Reserved */
    (uint32_t)&interrupt_handler,    /* Vector - 15    Reserved */
    (uint32_t)&interrupt_handler,    /* Vector - 16    Reserved */
    (uint32_t)&interrupt_handler,    /* Vector - 17    Reserved */
    (uint32_t)&interrupt_handler,    /* Vector - 18    Reserved */
    (uint32_t)&interrupt_handler,    /* Vector - 19    Reserved */
    (uint32_t)&interrupt_handler,    /* Vector - 20    Reserved */
    (uint32_t)&interrupt_handler,    /* Vector - 21    Reserved */
    (uint32_t)&interrupt_handler,    /* Vector - 22    Reserved */
    (uint32_t)&interrupt_handler,    /* Vector - 23    Reserved */
    (uint32_t)&interrupt_handler,    /* Vector - 24    Reserved */
    (uint32_t)&interrupt_handler,    /* Vector - 25    Reserved */
    (uint32_t)&interrupt_handler,    /* Vector - 26    Reserved */
    (uint32_t)&interrupt_handler,    /* Vector - 27    Reserved */
    (uint32_t)&interrupt_handler,    /* Vector - 28    interrupt_handler*/
    (uint32_t)&interrupt_handler,    /* Vector - 29    Reserved */
    (uint32_t)&interrupt_handler,    /* Vector - 30    interrupt_handler*/
    (uint32_t)&interrupt_handler,    /* Vector - 31    interrupt_handler*/
    (uint32_t)&interrupt_handler,    /* Vector - 32    interrupt_handler*/
    (uint32_t)&interrupt_handler,    /* Vector - 33    interrupt_handler*/
    (uint32_t)&interrupt_handler,    /* Vector - 34    Reserved */
    (uint32_t)&interrupt_handler,    /* Vector - 35    interrupt_handler*/
    (uint32_t)&interrupt_handler,    /* Vector - 36    interrupt_handler*/
    (uint32_t)&interrupt_handler,    /* Vector - 37    Reserved */
    (uint32_t)&interrupt_handler,    /* Vector - 38    interrupt_handler*/
    (uint32_t)&interrupt_handler,    /* Vector - 39    interrupt_handler*/
    (uint32_t)&interrupt_handler,    /* Vector - 40    Reserved */
    (uint32_t)&interrupt_handler,    /* Vector - 41    interrupt_handler*/
    (uint32_t)&interrupt_handler,    /* Vector - 42    interrupt_handler*/
    (uint32_t)&interrupt_handler,    /* Vector - 43    Reserved */
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
    (uint32_t)&interrupt_handler,    /* Vector - 271    Reserved */
    (uint32_t)&interrupt_handler,    /* Vector - 272    Reserved */
    (uint32_t)&interrupt_handler,    /* Vector - 273    Reserved */
    (uint32_t)&interrupt_handler,    /* Vector - 274    Reserved */
    (uint32_t)&interrupt_handler,    /* Vector - 275    Reserved */
    (uint32_t)&interrupt_handler,    /* Vector - 276    Reserved */
    (uint32_t)&interrupt_handler,    /* Vector - 277    Reserved */
    (uint32_t)&interrupt_handler,    /* Vector - 278    Reserved */
    (uint32_t)&interrupt_handler,    /* Vector - 279    Reserved */
    (uint32_t)&interrupt_handler,    /* Vector - 280    Reserved */
    (uint32_t)&interrupt_handler,    /* Vector - 281    Reserved */
    (uint32_t)&interrupt_handler,    /* Vector - 282    Reserved */
    (uint32_t)&interrupt_handler,    /* Vector - 283    Reserved */
    (uint32_t)&interrupt_handler,    /* Vector - 284    Reserved */
    (uint32_t)&interrupt_handler,    /* Vector - 285    Reserved */
    (uint32_t)&interrupt_handler,    /* Vector - 286    Reserved */
    (uint32_t)&interrupt_handler,    /* Vector - 287    Reserved */
    (uint32_t)&interrupt_handler,    /* Vector - 288    Reserved */
    (uint32_t)&interrupt_handler,    /* Vector - 289    Reserved */
    (uint32_t)&interrupt_handler,    /* Vector - 290    Reserved */
    (uint32_t)&interrupt_handler,    /* Vector - 291    Reserved */
    (uint32_t)&interrupt_handler,    /* Vector - 292    Reserved */
    (uint32_t)&interrupt_handler,    /* Vector - 293    Reserved */
};

#include "MPC5604B_0M27V_0102.h" /* Use proper include file */
#include "HardwareTRK-MPC5604B.h"

void interrupt_handler(void) {
	// [DEBUG]
	uint32_t j;
    
   	vfnSet_DCMotor1_Duty_Perc(0);
	vfnSet_DCMotor1_Back_Duty_Perc(0);
	vfnSet_DCMotor2_Duty_Perc(0);
	vfnSet_DCMotor2_Back_Duty_Perc(0);
	
	while (1) {
		for (j = 0; j < 0xfffff; j++) {}
		
		LED1 ^= 1;
	}
	// [\DEBUG]
	
	/* Wait forever or for watchdog timeout */
}
