ClaudioBorges/MicroFEI-SmartCarBrazil2011/TFC - SmartCar/ADC/adc_trigger_init.c

/*
 *######################################################################
 *                                RAppIDJDP
 *           Rapid Application Initialization and Documentation Tool
 *                         Freescale Semiconductor Inc.
 *
 *######################################################################
 *
 * Project Name           : SAIC ADC
 *
 * Project File           : SAIC ADC.rsp
 *
 * Revision Number        : 1.0
 *
 * Tool Version           : 1.3.1.6
 *
 * file                   : adc_trigger_init.c
 *
 * Target Compiler        : Diab
 *
 * Target Part            : MPC5604B
 *
 * Part Errata Fixes      : none
 *
 * Project Last Save Date : 06-Aug-2011 12:22:55
 *
 * Created on Date        : 06-Aug-2011 12:33:44
 *
 * Brief Description      : This File contains the utility function used to
 *                          trigger ADC Sampling.
 *
 ******************************************************************************** 
 *
 * Detail Description     : This File contains utility function which can trigger
 *                         Normal & Injected Sampling and Abort Normal and chain
 *                         conversion and power down mode These functions are never
 *                         called by RAppID.
 *
 ******************************************************************************** 
 *
 *######################################################################
*/

 
 
/********************  Dependent Include files here **********************/

#include "adc_trigger_init.h"
#include "MPC5604B_0M27V_0102.h" /* Use proper include file */


/*********************  Normal Software Trigger Function ************************/

void adc_normal_start_fnc(void)
{
    ADC.MCR.B.NSTART = 1; 
        /* Starts The Normal ADC Conversion */

}

/*********************  Injected Software Trigger Function ************************/

void adc_injected_start_fnc(void)
{
    ADC.MCR.B.JSTART = 1;
        /* Starts The Injected ADC Conversion */

}

/*********************  Normal Software Conversion  Stop Function ************************/

void adc_normal_stop_fnc(void)
{
    ADC.MCR.B.ABORT = 1; 
        /*  Stops The Normal ADC Conversion */

}

/*********************  Stop ADC Chain Conversion Function ************************/

void adc_chain_stop_fnc(void)
{
    ADC.MCR.B.ABORTCHAIN = 1; 
        /*  Stops The ADC chain Conversion */

}

/*********************  Power Down Mode Control Function ************************/

void adc_enter_powerdown_mode(void)
{
    ADC.MCR.B.PWDN = 1; 
        /* Power Down Mode enabled */

}

void adc_exit_powerdown_mode(void)
{
    ADC.MCR.B.PWDN = 0; 
        /* Power Down Mode disabled */

}

 
/*
 *######################################################################
 *                           End of File
 *######################################################################
*/
