ClaudioBorges/MicroFEI-SmartCarBrazil2011/TFC - SmartCar/SIU/siu_init.h

/*
 *######################################################################
 *                                RAppIDJDP
 *           Rapid Application Initialization and Documentation Tool
 *                         Freescale Semiconductor Inc.
 *
 *######################################################################
 *
 * Project Name           : SAIC ADC
 *
 * Project File           : SAIC ADC.rsp
 *
 * Revision Number        : 1.0
 *
 * Tool Version           : 1.3.1.6
 *
 * file                   : siu_init.h
 *
 * Target Compiler        : Diab
 *
 * Target Part            : MPC5604B
 *
 * Part Errata Fixes      : none
 *
 * Project Last Save Date : 06-Aug-2011 13:15:20
 *
 * Created on Date        : 06-Aug-2011 13:15:24
 *
 * Brief Description      : This File contains functions declaration of SIU code file
 *
 *
 *######################################################################
*/

#ifndef  _SIU_INIT_H
#define  _SIU_INIT_H
/********************  Dependent Include files here **********************/

void siu_init_fnc(void);
void siu_portA_init_fnc(void);
void siu_portB_init_fnc(void);
void siu_portC_init_fnc(void);
void siu_portD_init_fnc(void);
void siu_portE_init_fnc(void);
void siu_portF_init_fnc(void);
void siu_portG_init_fnc(void);
void siu_portH_init_fnc(void);
void siu_general_init_fnc(void);
void siu_parallel_port_init_fnc(void);
void siu_unused_pins_init_fnc(void);
void siu_psmi_init_fnc(void);



#endif  /*_SIU_INIT_H*/

/*
 *######################################################################
 *                           End of File
 *######################################################################
*/
